VikingMotorsports/Battery-Management-System-Capstone/README.md

# VMS Battery Management Capstone 2026 Repo

All System Architecture KiCAD Schematics and GERBER files along with the zephyr firmware C code.
