VikingMotorsports/Battery-Management-System-Capstone/docs/Final_Project_Report/glossary.tex

\makeglossaries
\newacronym{vms}{VMS}{Viking Motorsports}
\newacronym{bms}{BMS}{Battery Management System}
\newacronym{ecu}{ECU}{Energy Control Unit}
\newacronym{can}{CAN}{Control Area Network}
\newacronym{can-fd}{CAN-FD}{\gls{can} Fast Data}
\newacronym{bmu}{BMU}{Battery Management Unit}
