VikingMotorsports/Battery-Management-System-Capstone/docs/Final_Project_Report/Section_4.tex

\subsection{Objectives}

\subsection{Deliverables}

Using the Atlassian suite of tools which include Jira, Bitbucket, and Confluence to deliver on the following

\begin{itemize}
	\item Project proposal
	\item Weekly Progress Reports
	\item Final report
	\item ECE Capstone Poster Session poster
	\item Detailed design documentation, explaining what your design does, how your design works, and why you made the decisions you did
	\item Electrical CAD: Schematics and board layouts, including output files (Gerbers, PDFs, etc)
	\item Mechanical CAD: enclosures, mechanisms, including output files (STLs, PDFs, etc)
	\item Bill of materials and pricing
	\item Developer's manual for future teams improveing on the existing design
	\item Short user manuals documenting how to use your creation
	\item A working prototype with a prototype battery pack and functionality with the \gls{ecu} prototype.
\end{itemize}
