VikingMotorsports/Battery-Management-System-Capstone/docs/Project_Proposal/Section_1.tex

Our team will design the next-generation battery system for PSU’s electric Formula race car, EV27, in partnership with \gls{vms} and our faculty advisor. The current EV program does not have a usable accumulator, so the car won’t run. Over the next two terms we will create a complete, competition-ready design for the high voltage battery pack and its \gls{bms}, plus working low voltage prototype that demonstrates the core functions. The car we’re designing this battery for will compete in a Formula-style racing competition where universities bring their own cars to do a race competition.
