VikingMotorsports/Battery-Management-System-Capstone/docs/Project_Proposal/Section_4.tex

\subsection{Project Timeline}

Here is the link to the \href{https://docs.google.com/spreadsheets/d/1yp_52nIF2XpA4CjM_36LT811xkz6WF1V7Pj9z-nbfzA/edit?usp=sharing}{\underline{gantt chart}} for our project.

\subsection{Budget and Resources}
Our budget as per the industry sponsor is \$1000+. This should cover:
\begin{itemize}
	\item PCB Fabrication and Assembly
	\item Electronic Components (cell monitoring ICs, microcontroller, sensors, actuators)
	\item Development/Evaluation Boards
	\item Testing and Miscellaneous
	\item Mechanical Design Enclosures
\end{itemize}
These are some of the resources that we may utilize:
\begin{itemize}
	\item EPL
	\item Soldering and rework equipment
	\item Multimeter
	\item PSU labs for design and testing
	\item Logic analyzer
	\item Oscilloscope
\end{itemize}

\subsection{Intellectual Property Discussion}
The IP is owned by the \gls{vms} student group.

\subsection{Team}

\subsubsection{Members and their skills}

\begin{itemize}
	\item \textbf{Hussein Khodor, Computer Engineering:} Embedded systems programming (C/C++), microcontroller development, Python scripting
	
	\item \textbf{Jose Ramirez, Computer Engineering:} Embedded systems programming (C/C++), microcontroller development, communication protocols (CAN, SPI, I2C), PCB layout and design
	
	\item \textbf{David Fransis, Electrical Engineering:} Analog circuit design, PCB layout and design, power electronics, battery chemistry
	
	\item \textbf{Fangdong Yuan, Electrical Engineering:} Analog circuit design, PCB layout and design, power electronics
\end{itemize}

\subsubsection{Roles}

\begin{itemize}
	\item \textbf{Hussein Khodor, Software Team:} Data acquisition and processing
	
	\item \textbf{Jose Ramirez, Software Team:} CAN bus interfacing
	
	\item \textbf{David Fransis, Hardware Team:} Battery protection circuitry, voltage and temperature sensors
	
	\item \textbf{Fangdong Yuan, Hardware Team:} Cell balancing, fault logging
\end{itemize}

\textbf{Jose Ramirez shall take the responsibility of team leader.}

\subsection{Development Tools and Process}

The team plans to follow an iterative and agile-inspired development process, emphasizing early prototypes, incremental feature development, and frequent testing. Rather than attempting a single fully featured implementation, the project will progress through multiple functional prototypes, each adding capability and validation.

Collaboration and project management tools include:
\begin{itemize}
	\item \textbf{Version Control:} Bitbucket (schematics, PCB layouts, firmware documentation)
	\item \textbf{Task Management:} Jiro for sprint planning and tracking
	\item \textbf{Communication:} Discord/Slack for daily communication
	\item \textbf{Documentation:} Confluence/Google Drive for shared documents
\end{itemize}

From a technical perspective, development tools are expected to include:
\begin{itemize}
	\item \textbf{PCB Design:} KiCad
	\item \textbf{Circuit Simulator:} LTspice or KiCad simulation tools
	\item \textbf{Firmware Development:} Arduino IDE or PlatformIO with VSCode
	\item \textbf{Programming Languages:} C/C++ for embedded firmware, Python for test scripts
	\item \textbf{CAN Bus Analysis:} Saleae Logic 2, Sigrok Pulseview
	\item \textbf{3D Modeling CAD:} Fusion 360, SolidWorks, Onshape
	\item \textbf{Documentation:} LaTeX, Microsoft Word, Google Docs
\end{itemize}
