VikingMotorsports/Battery-Management-System-Capstone/docs/Project_Proposal/Section_5.tex

Here is the proof that our industry sponsor approved of our Proposal.

\begin{figure}[H]
	
	\caption{Sponsor Sign Off}
	\label{fig:Sign_Off}
\end{figure}

We weren't able to get the faculty advisor signature as they are out of the country and unavailable the week of submission.
