VikingMotorsports/Battery-Management-System-Capstone/Hardware/BMU/BMU.kicad_pcb

## KiCad design Hardware/BMU/BMU.kicad_pcb (2026-04-28)

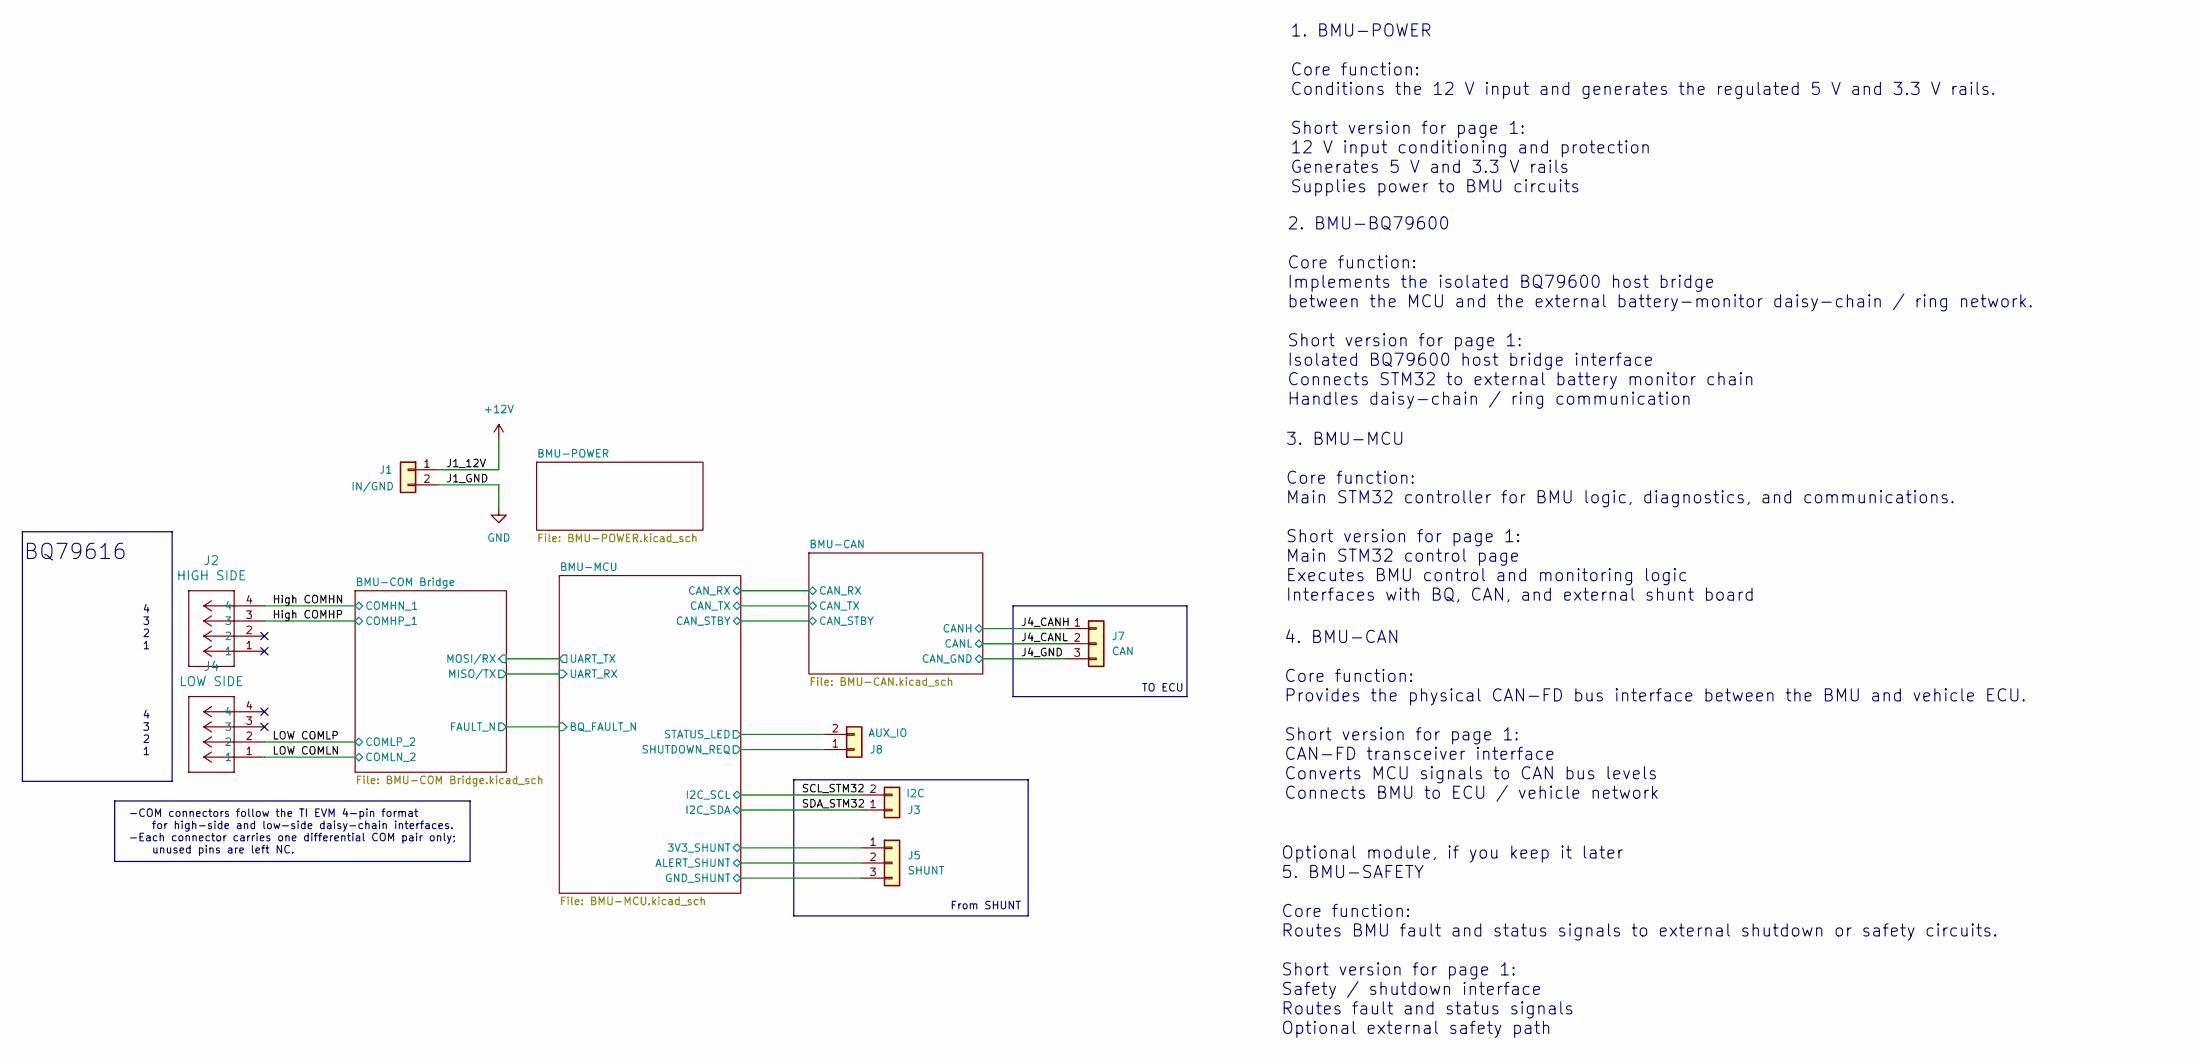
[picture p9: schematic BMU.kicad_sch, BATTERY MANAGEMENT UNIT (BMU)]

Parts:
J1: IN/GND; PinHeader_1x02_P2.54mm_Vertical
J2: HIGH SIDE; CONN_70551-xxxx_04_MOL
J3: I2C; PinHeader_1x02_P2.54mm_Vertical
J4: LOW SIDE; CONN_70551-xxxx_04_MOL
J5: SHUNT; PinHeader_1x03_P2.54mm_Vertical
J7: CAN; PinHeader_1x03_P2.54mm_Vertical
J8: AUX_IO; PinHeader_1x02_P2.54mm_Vertical

Connections:
+3V3: J5.1; also elsewhere on the board
+12V: J1.1; also elsewhere on the board
/BMU-MCU/ALERT_SHUNT: J5.2; also elsewhere on the board
/BMU-MCU/SHUTDOWN_REQ: J8.1; also elsewhere on the board
/BMU-MCU/STATUS_LED: J8.2; also elsewhere on the board
/High COMHN: J2.4; also elsewhere on the board
/High COMHP: J2.3; also elsewhere on the board
/J4_CANH: J7.1; also elsewhere on the board
/J4_CANL: J7.2; also elsewhere on the board
/LOW COMLN: J4.1; also elsewhere on the board
/LOW COMLP: J4.2; also elsewhere on the board
/SCL_STM32: J3.2; also elsewhere on the board
/SDA_STM32: J3.1; also elsewhere on the board
GND: J1.2, J5.3, J7.3; also elsewhere on the board

Notes on the sheet:
4 3 2 1
2. BMU-BQ79600 Core function: Implements the isolated BQ79600 host bridge between the MCU and the external battery-monitor daisy-chain / ring network. Short version for page 1: Isolated BQ79600 host bridge interface Connects STM32 to external battery monitor chain Handles daisy-chain / ring communi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
-COM connectors follow the TI EVM 4-pin format for high-side and low-side daisy-chain interfaces. -Each connector carries one differential COM pair only; unused pins are left NC.
4. BMU-CAN Core function: Provides the physical CAN-FD bus interface between the BMU and vehicle ECU. Short version for page 1: CAN-FD transceiver interface Converts MCU signals to CAN bus levels Connects BMU to ECU / vehicle network
3. BMU-MCU Core function: Main STM32 controller for BMU logic, diagnostics, and communications. Short version for page 1: Main STM32 control page Executes BMU control and monitoring logic Interfaces with BQ, CAN, and external shunt board
TO ECU
1. BMU-POWER Core function: Conditions the 12 V input and generates the regulated 5 V and 3.3 V rails. Short version for page 1: 12 V input conditioning and protection Generates 5 V and 3.3 V rails Supplies power to BMU circuits
From SHUNT
BQ79616
Optional module, if you keep it later 5. BMU-SAFETY Core function: Routes BMU fault and status signals to external shutdown or safety circuits. Short version for page 1: Safety / shutdown interface Routes fault and status signals Optional external safety path

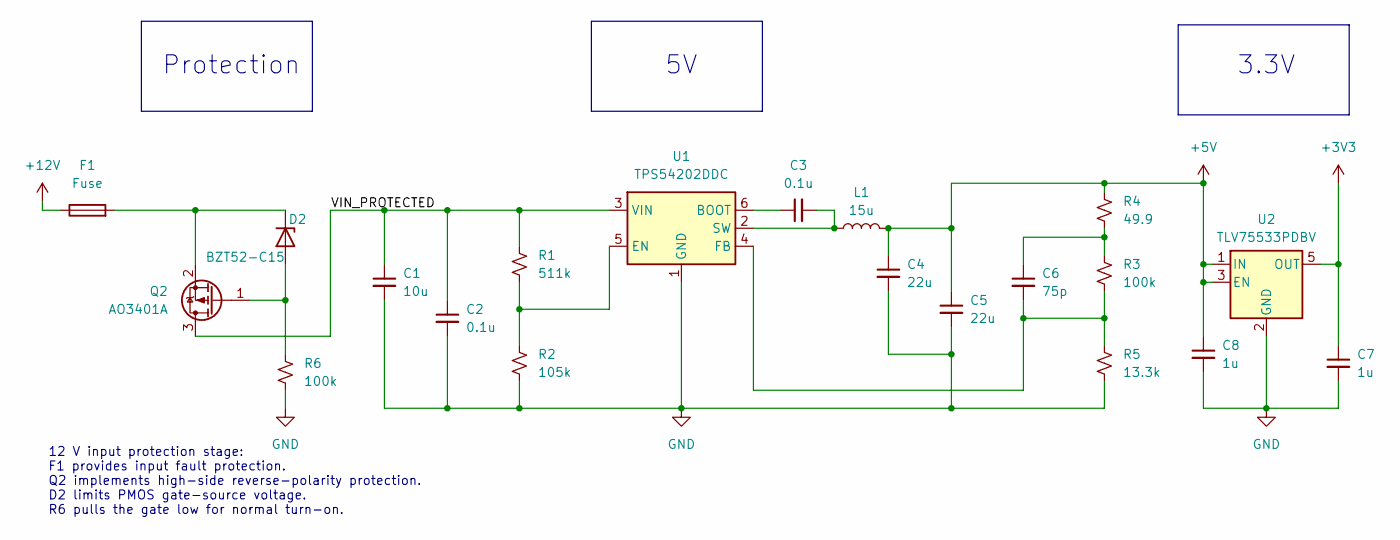
[picture p10: schematic BMU-POWER.kicad_sch, BATTERY MANAGEMENT UNIT (BMU)]

Parts:
C1: 10u; C_1206_3216Metric
C2, C3: 0.1u; C_0805_2012Metric
C4, C5: 22u; C_1206_3216Metric
C6: 75p; C_0805_2012Metric
C7, C8: 1u; C_0805_2012Metric
D2: BZT52-C15; D_SOD-123
F1: Fuse; Fuse_1206_3216Metric
L1: 15u; L_7.3x7.3_H4.5
Q2: AO3401A; SOT-23
R1: 511k; R_0805_2012Metric
R2: 105k; R_0805_2012Metric
R3, R6: 100k; R_0805_2012Metric
R4: 49.9; R_0805_2012Metric
R5: 13.3k; R_0805_2012Metric
U1: TPS54202DDC; SOT-23-6
U2: TLV75533PDBV; SOT-23-5

Connections:
+3V3: C7.1, U2.5 (OUT); also elsewhere on the board
+5V: C4.1, C5.1, C8.1, L1.2, R4.1, U2.1 (IN), U2.3 (EN); also elsewhere on the board
+12V: F1.1; also elsewhere on the board
/BMU-POWER/VIN_PROTECTED: C1.1, C2.1, Q2.3 (D), R1.1, U1.3 (VIN)
GND: C1.2, C2.2, C4.2, C5.2, C7.2, C8.2, R2.2, R5.2, R6.2, U1.1 (GND), U2.2 (GND); also elsewhere on the board
unnamed: C6.1, R3.1, R4.2
unnamed: D2.2 (A), Q2.1 (G), R6.1
unnamed: D2.1 (K), F1.2, Q2.2 (S)
unnamed: C3.1, U1.6 (BOOT)
unnamed: R1.2, R2.1, U1.5 (EN)
unnamed: C6.2, R3.2, R5.1, U1.4 (FB)
unnamed: C3.2, L1.1, U1.2 (SW)

Notes on the sheet:
3.3V
Protection
12 V input protection stage: F1 provides input fault protection. Q2 implements high-side reverse-polarity protection. D2 limits PMOS gate-source voltage. R6 pulls the gate low for normal turn-on.

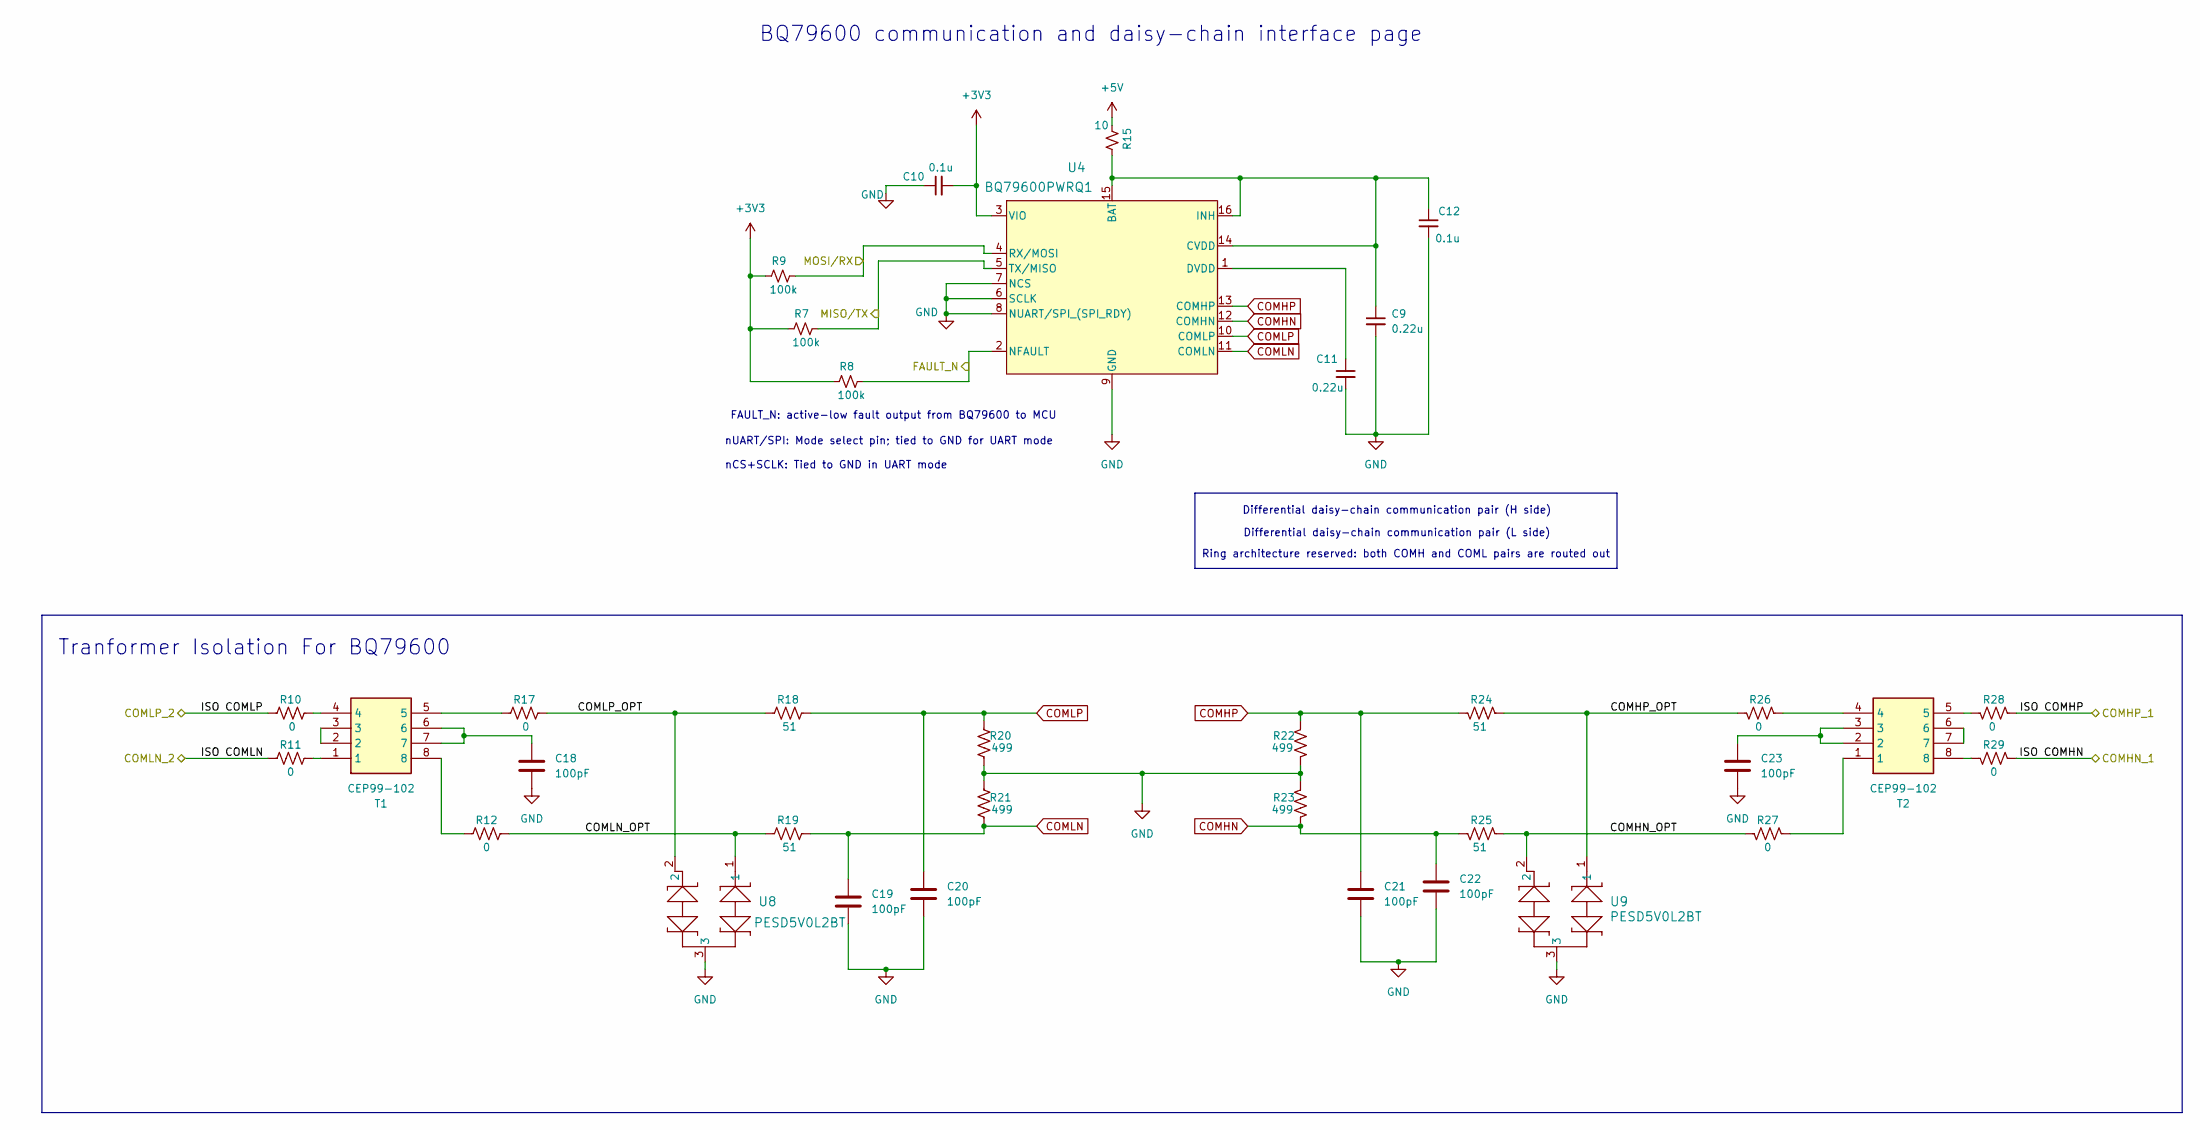
[picture p11: schematic BMU-COM Bridge.kicad_sch, BATTERY MANAGEMENT UNIT (BMU)]

Parts:
C9, C11: 0.22u; C_0805_2012Metric
C10, C12: 0.1u; C_0805_2012Metric
C18, C19, C20, C21, C22, C23: 100pF; C_0805_2012Metric
R7, R8, R9: 100k; R_0805_2012Metric
R10, R11, R12, R17, R26, R27, R28, R29: 0; R_0805_2012Metric
R15: 10; R_0805_2012Metric
R18, R19, R24, R25: 51; R_0805_2012Metric
R20, R21, R22, R23: 499; R_0805_2012Metric
T1, T2: CEP99-102; CEP99102; Manufacturer_Part_Number CEP99-102
U4: BQ79600PWRQ1; TSSOP16_PW_TEX
U8, U9: PESD5V0L2BT; SOT23_NEX

Connections:
+3V3: C10.2, R7.1, R8.1, R9.1, U4.3 (VIO); also elsewhere on the board
+5V: R15.1; also elsewhere on the board
/BMU-COM Bridge/COMHN_OPT: R25.1, R27.2, U9.2
/BMU-COM Bridge/COMHP_OPT: R24.1, R26.2, U9.1
/BMU-COM Bridge/COMLN_OPT: R12.2, R19.1, U8.1
/BMU-COM Bridge/COMLP_OPT: R17.2, R18.1, U8.2
/BMU-COM Bridge/FAULT_N: R8.2, U4.2 (NFAULT); also elsewhere on the board
/BMU-COM Bridge/MISO/TX: R7.2, U4.5 (TX/MISO); also elsewhere on the board
/BMU-COM Bridge/MOSI/RX: R9.2, U4.4 (RX/MOSI); also elsewhere on the board
/High COMHN: R29.1; also elsewhere on the board
/High COMHP: R28.1; also elsewhere on the board
/LOW COMLN: R11.1; also elsewhere on the board
/LOW COMLP: R10.1; also elsewhere on the board
COMHN: C22.1, R23.2, R25.2, U4.12 (COMHN)
COMHP: C21.1, R22.1, R24.2, U4.13 (COMHP)
COMLN: C19.1, R19.2, R21.2, U4.11 (COMLN)
COMLP: C20.1, R18.2, R20.1, U4.10 (COMLP)
GND: C9.2, C10.1, C11.2, C12.2, C18.2, C19.2, C20.2, C21.2, C22.2, C23.2, R20.2, R21.1, R22.2, R23.1, U4.6 (SCLK), U4.7 (NCS), U4.8 (NUART/SPI_(SPI_RDY)), U4.9 (GND), U8.3, U9.3; also elsewhere on the board
unnamed: C18.1, T1.6, T1.7
unnamed: C23.1, T2.2, T2.3
unnamed: R10.2, T1.4
unnamed: R11.2, T1.1
unnamed: R12.1, T1.8
unnamed: R17.1, T1.5
unnamed: R26.1, T2.4
unnamed: R27.1, T2.1
unnamed: R28.2, T2.5
unnamed: R29.2, T2.8
unnamed: T1.2, T1.3
unnamed: T2.6, T2.7
unnamed: C9.1, C12.1, R15.2, U4.14 (CVDD), U4.15 (BAT), U4.16 (INH)
unnamed: C11.1, U4.1 (DVDD)

Notes on the sheet:
Differential daisy-chain communication pair (H side)
Tranformer Isolation For BQ79600
Differential daisy-chain communication pair (L side)
BQ79600 communication and daisy-chain interface page
Ring architecture reserved: both COMH and COML pairs are routed out
nUART/SPI: Mode select pin; tied to GND for UART mode
FAULT_N: active-low fault output from BQ79600 to MCU
nCS+SCLK: Tied to GND in UART mode

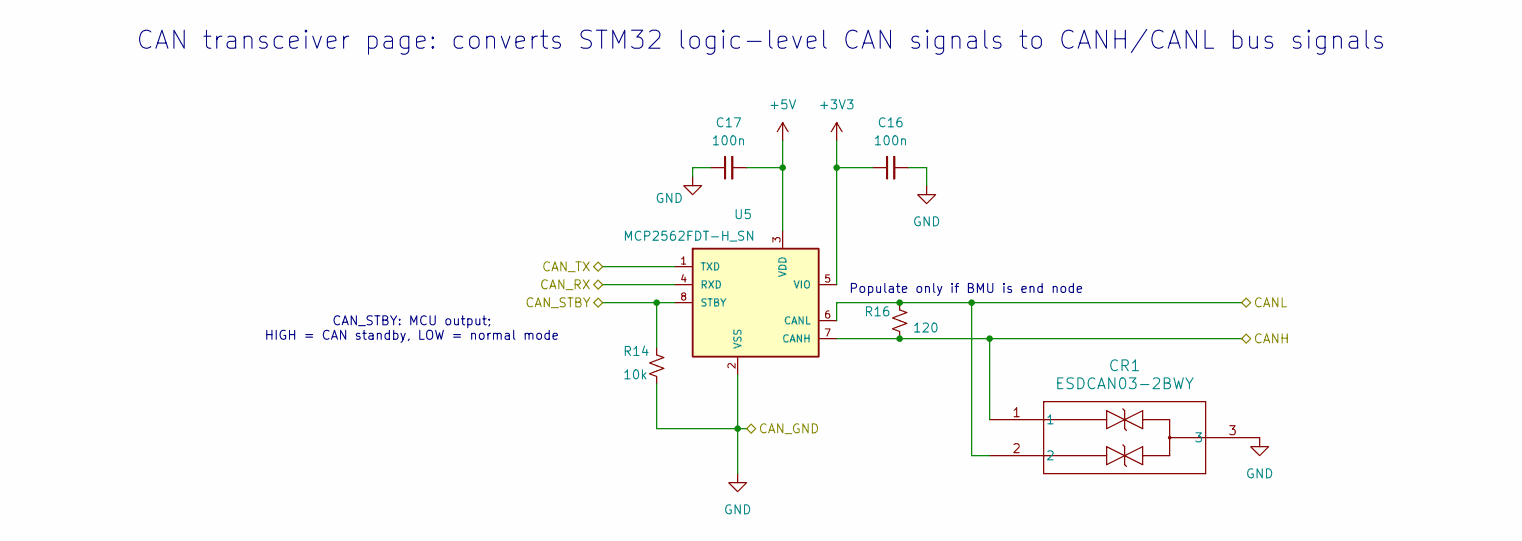
[picture p12: schematic BMU-CAN.kicad_sch, BATTERY MANAGEMENT UNIT (BMU)]

Parts:
C16, C17: 100n; C_0805_2012Metric
CR1: ESDCAN03-2BWY; SOT323-3L_STM
R14: 10k; R_0805_2012Metric
R16: 120; R_0805_2012Metric
U5: MCP2562FDT-H_SN; SOIC127P600X175-8N

Connections:
+3V3: C16.1, U5.5 (VIO); also elsewhere on the board
+5V: C17.2, U5.3 (VDD); also elsewhere on the board
/BMU-CAN/CAN_RX: U5.4 (RXD); also elsewhere on the board
/BMU-CAN/CAN_STBY: R14.1, U5.8 (STBY); also elsewhere on the board
/BMU-CAN/CAN_TX: U5.1 (TXD); also elsewhere on the board
/J4_CANH: CR1.1, R16.2, U5.7 (CANH); also elsewhere on the board
/J4_CANL: CR1.2, R16.1, U5.6 (CANL); also elsewhere on the board
GND: C16.2, C17.1, CR1.3, R14.2, U5.2 (VSS); also elsewhere on the board

Notes on the sheet:
CAN_STBY: MCU output; HIGH = CAN standby, LOW = normal mode
Populate only if BMU is end node
CAN transceiver page: converts STM32 logic-level CAN signals to CANH/CANL bus signals

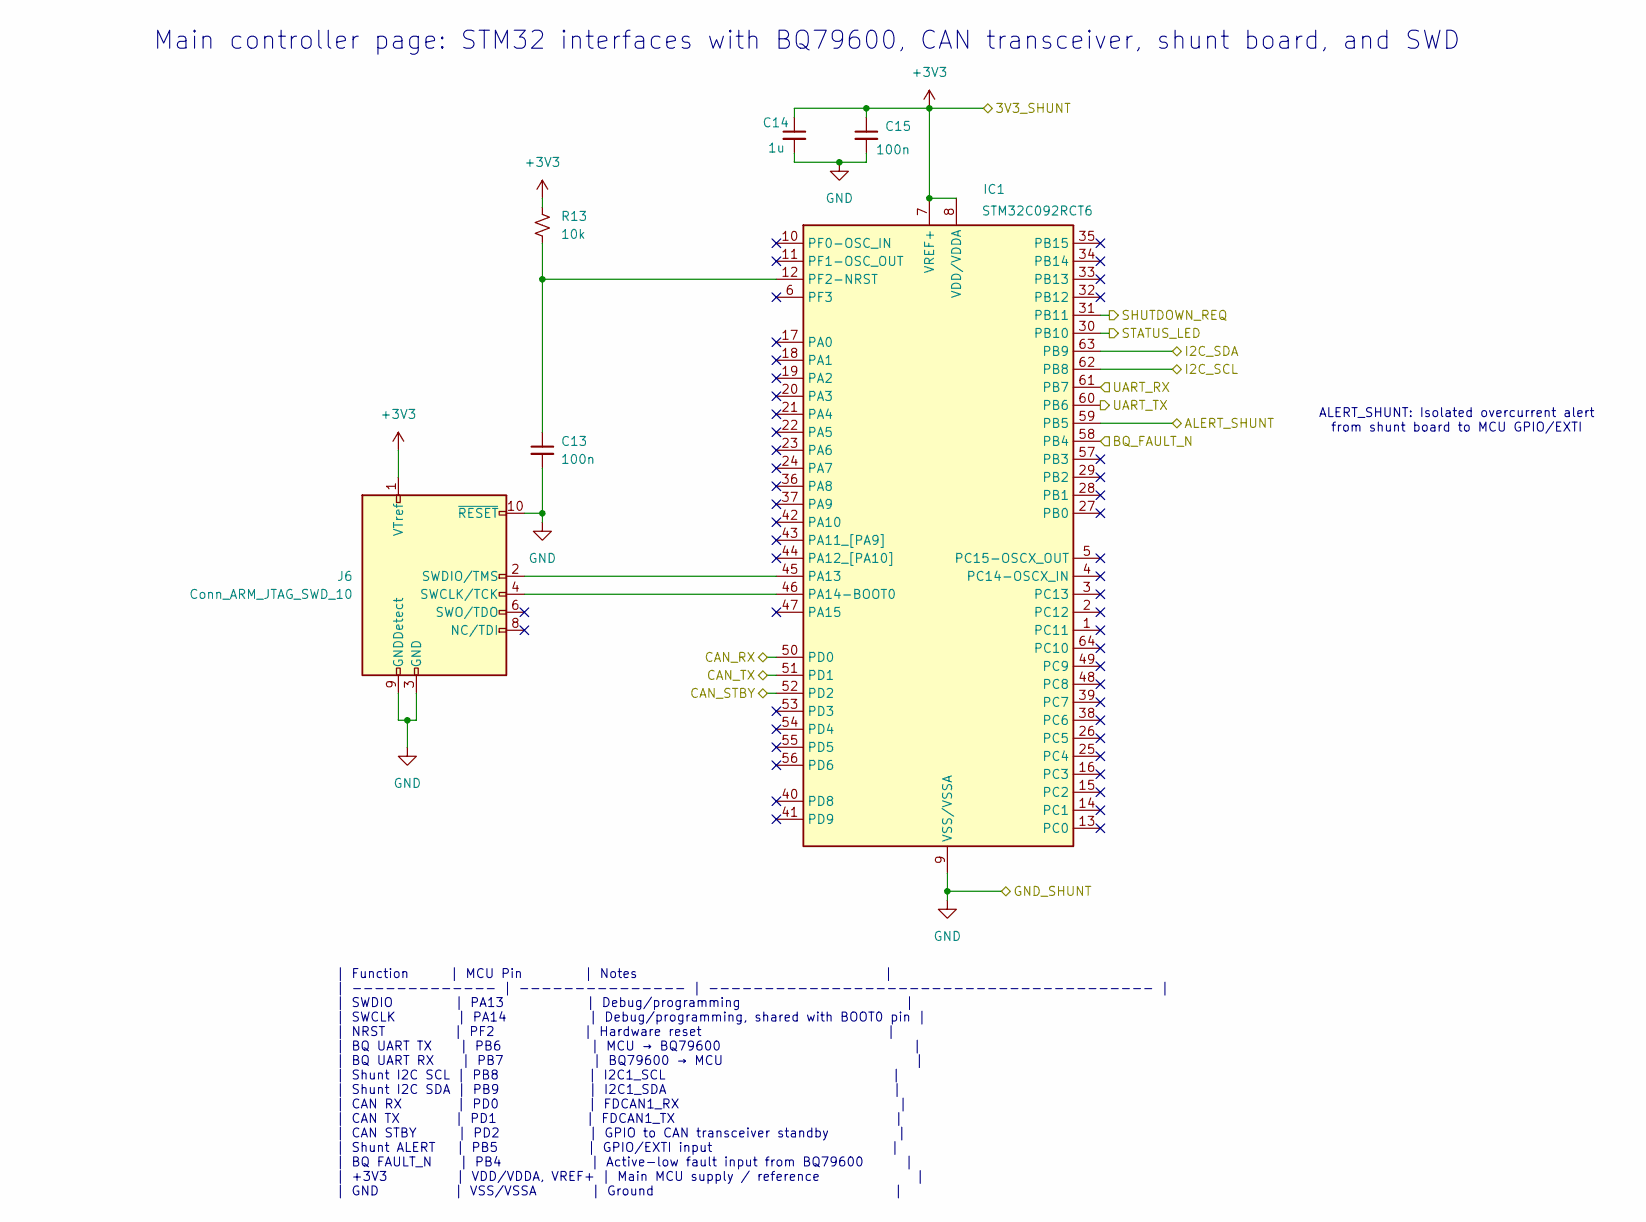
[picture p13: schematic BMU-MCU.kicad_sch, BATTERY MANAGEMENT UNIT (BMU)]

Parts:
C13, C15: 100n; C_0805_2012Metric
C14: 1u; C_0805_2012Metric
IC1: STM32C092RCT6; QFP50P1200X1200X160-64N; Manufacturer_Part_Number STM32C092RCT6; Mouser Part Number 511-STM32C092RCT6
J6: Conn_ARM_JTAG_SWD_10; PinHeader_2x05_P1.27mm_Vertical
R13: 10k; R_0805_2012Metric

Connections:
+3V3: C14.1, C15.1, IC1.7 (VREF+), IC1.8 (VDD/VDDA), J6.1 (VTref), R13.1; also elsewhere on the board
/BMU-CAN/CAN_RX: IC1.50 (PD0); also elsewhere on the board
/BMU-CAN/CAN_STBY: IC1.52 (PD2); also elsewhere on the board
/BMU-CAN/CAN_TX: IC1.51 (PD1); also elsewhere on the board
/BMU-COM Bridge/FAULT_N: IC1.58 (PB4); also elsewhere on the board
/BMU-COM Bridge/MISO/TX: IC1.61 (PB7); also elsewhere on the board
/BMU-COM Bridge/MOSI/RX: IC1.60 (PB6); also elsewhere on the board
/BMU-MCU/ALERT_SHUNT: IC1.59 (PB5); also elsewhere on the board
/BMU-MCU/SHUTDOWN_REQ: IC1.31 (PB11); also elsewhere on the board
/BMU-MCU/STATUS_LED: IC1.30 (PB10); also elsewhere on the board
/SCL_STM32: IC1.62 (PB8); also elsewhere on the board
/SDA_STM32: IC1.63 (PB9); also elsewhere on the board
GND: C13.2, C14.2, C15.2, IC1.9 (VSS/VSSA), J6.3 (GND), J6.5 (GND), J6.9 (GNDDetect), J6.10 (~RESET); also elsewhere on the board
unnamed: IC1.45 (PA13), J6.2 (SWDIO/TMS)
unnamed: IC1.46 (PA14-BOOT0), J6.4 (SWCLK/TCK)
unnamed: C13.1, IC1.12 (PF2-NRST), R13.2

Notes on the sheet:
| Function | MCU Pin | Notes | | ------------- | --------------- | ---------------------------------------- | | SWDIO | PA13 | Debug/programming | | SWCLK | PA14 | Debug/programming, shared with BOOT0 pin | | NRST | PF2 | Hardware reset | | BQ UART TX | PB6 | MCU → BQ79600 | | BQ UART RX | PB7 | BQ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
Main controller page: STM32 interfaces with BQ79600, CAN transceiver, shunt board, and SWD
ALERT_SHUNT: Isolated overcurrent alert from shunt board to MCU GPIO/EXTI

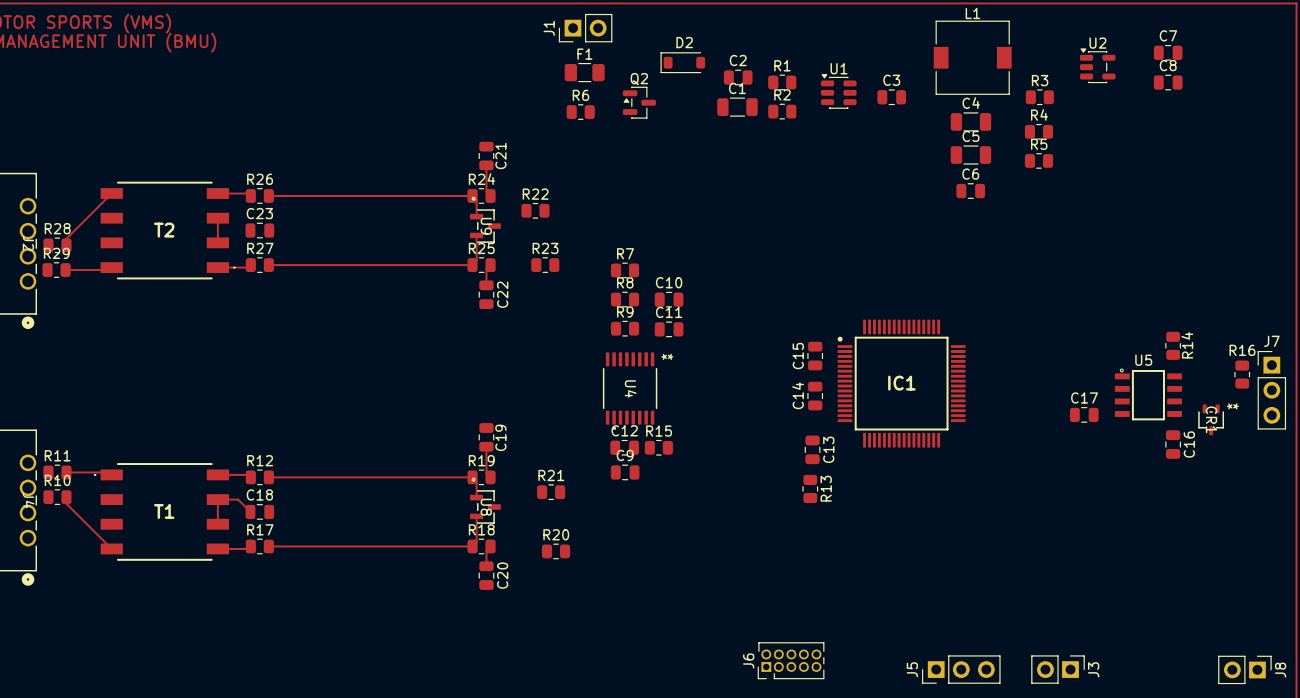
[picture p14: board BMU.kicad_pcb from above]

Board: 4 copper layers, 74 parts (0 on the bottom side), 54 nets.
