VikingMotorsports/Battery-Management-System-Capstone/(commit log)

2026-04-03 Hardware Schematics Added
    [BMS.kicad_sch, BQ79600.kicad_sch]
2026-04-17 Add BMS monitor with UART, frame protocol, initialization, and cell voltage monitoring
2026-04-19 Add BMU schematic sheets
    [BMS.kicad_pcb, BMS.kicad_sch, BMU-BQ79600.kicad_sch, BMU-CAN.kicad_sch, BMU-MCU.kicad_sch, BMU-POWER.kicad_sch, BMU-SHUNT.kicad_sch, BMU_shutdown.kicad_sch]
2026-04-20 Hardware Directory Reorganization
    [BMS.kicad_pcb, BMU-BQ79600.kicad_sch, BMU-CAN.kicad_sch, BMU-MCU.kicad_sch, BMU-POWER.kicad_sch, BMU-SHUNT.kicad_sch, BMU.kicad_pcb, BMU.kicad_sch]
2026-04-21 update CAN and SHUNT IF
    [BMS.kicad_sch, BMU-BQ79600.kicad_sch, BMU-CAN.kicad_sch, BMU-MCU.kicad_sch, BMU-POWER.kicad_sch, BMU-SHUNT.kicad_sch]
2026-04-21 Current SHUNT module added
    [Shunt circuit.kicad_pcb, Shunt circuit.kicad_sch]
2026-04-21 Hardware Projects Organized
    [BMU-BQ79600.kicad_sch, BMU-CAN.kicad_sch, BMU-MCU.kicad_sch, BMU-POWER.kicad_sch, BMU-SHUNT.kicad_sch, BMU.kicad_pcb, BMU.kicad_sch, BMU_shutdown.kicad_sch]
2026-04-21 change CAN
    [BMU-BQ79600.kicad_sch, BMU-CAN.kicad_sch, BMU-MCU.kicad_sch, BMU-POWER.kicad_sch, BMU-SHUNT.kicad_sch, BMU.kicad_sch, BMU_shutdown.kicad_sch]
2026-04-22 add comment
    [BMU-BQ79600.kicad_sch, BMU-CAN.kicad_sch, BMU-MCU.kicad_sch, BMU-POWER.kicad_sch, BMU.kicad_sch]
2026-04-22 Added Zephyr logging for error/status recording
    [init.c, main.c, uart.c]
2026-04-22 add footprint
    [BMU-BQ79600.kicad_sch, BMU-CAN.kicad_sch, BMU-MCU.kicad_sch, BMU-POWER.kicad_sch, BMU.kicad_pcb, BMU.kicad_sch]
2026-04-23 add iso
    [BMU-BQ79600.kicad_sch, BMU-ISO.kicad_sch, BMU.kicad_sch]
2026-04-24 Added temperature monitoring for on board NTC thermistors
2026-04-25 update bmu
    [BMU-BQ79600.kicad_sch, BMU-CAN.kicad_sch, BMU-COM Bridge.kicad_sch, BMU-ISO.kicad_sch, BMU-MCU.kicad_sch, BMU-POWER.kicad_sch, BMU.kicad_sch]
